JWahaus/TinyLIon/Completed_Circuit.jpg

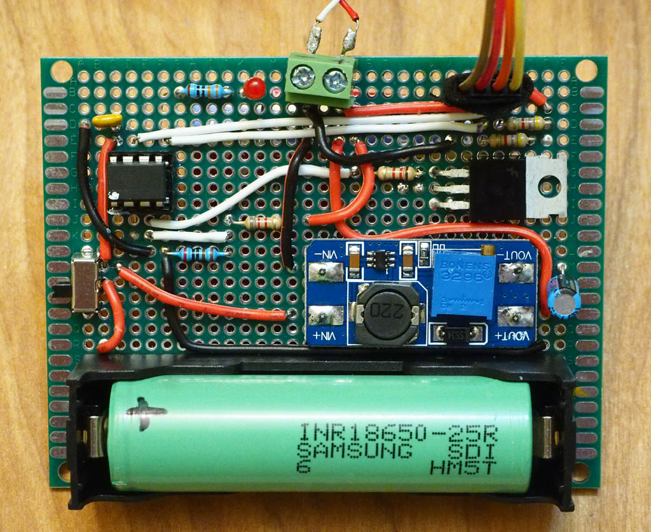
Completed_Circuit.jpg
