JWahaus/TinyLIon/Optional_LCD.jpg

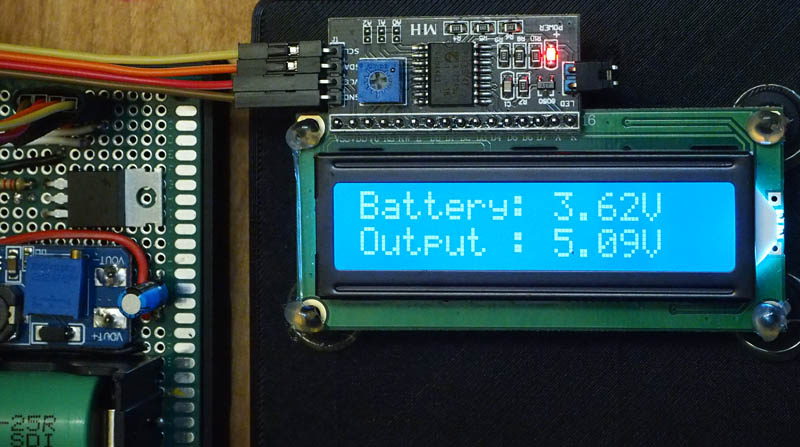
Optional_LCD.jpg
