JWahaus/TinyLIon/README.md

# TinyLIon
An ATiny85 based Lithium-Ion Battery Cell Boost, Protection, and Monitor Circuit

This program relys on the Arduino TinyWire and LiquidCrystal_attiny libraries for
I2c communication to an LCD display (with I2C backpack module).

The LCD display is optional (and detachable).  It's used for displaying the Battery
and Boost Module output voltages.
