JWahaus/TinyLIon/ATtiny85_LIon_schematic.png

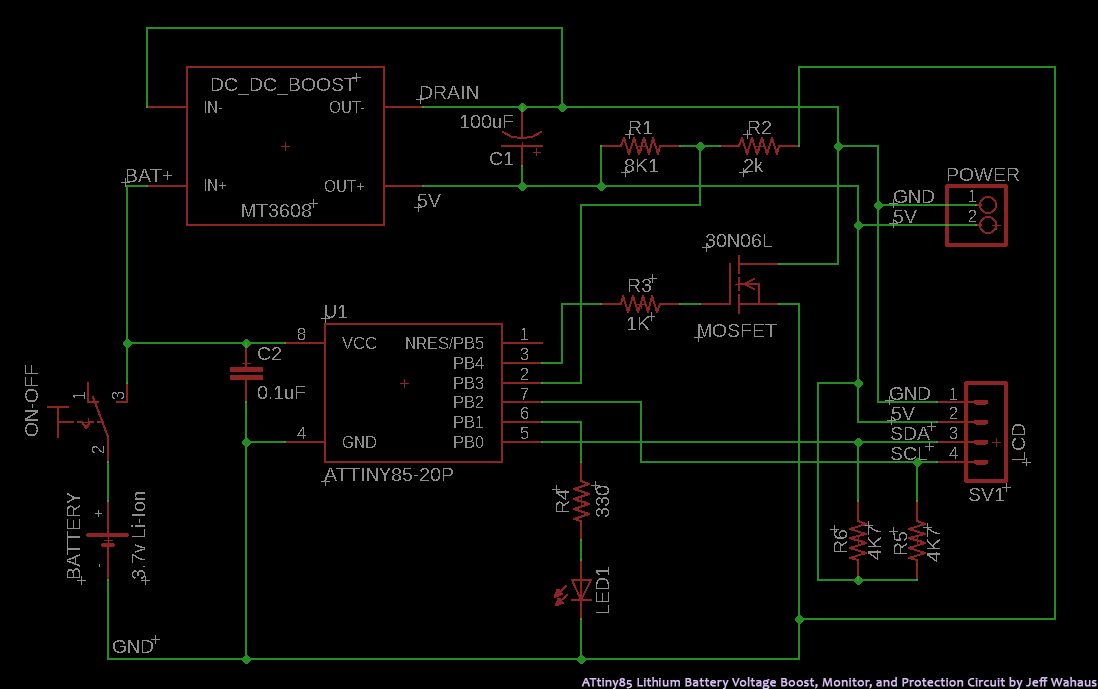
ATtiny85_LIon_schematic.png
